federicovolpe/telescopic/(commit log)

2024-04-11 riordinato il file markdown
2024-04-12 primo pid funzionante
2024-05-08 funzionante ad assemblaggio terminato
2024-05-11 funzionante senza pid
2024-05-15 finalizzato il readme
2024-05-15 sistemato il codice V1
